UN7FGO/MK61S_MINI/doc/MK61s-mini-Terminal.pdf

Проект
«Эмулятор микрокалькулятора «Электроника МК-61s mini» https://github.com/UN7FGO/MK61S_MINI

Руководство по работе с терминалом

Подключение к терминалу производится через последовательный порт ПК при помощи любой программы терминала, например Putty, TeraTerm или терминала ArduinoIDE. Характеристики соединения:

- 115200 Bod
- 8 bit + 1 bit четности

Предпочтительный размер окна терминала, 40 строк по 80 символов в строке. Для корректного отображения символов кириллицы, установите кодовую страницу Win1251.

Небольшое лирическое отступление, о терминале и том, что мы в нем наделали

Ввиду того, что само устройство, как и оригинал, не обладают большим дисплеем и не в состоянии отображать много информации одновременно, было решено создать инструмент, который позволит получить доступ к “внутреннему миру” устройства в более комфортном виде. Для этих целей и был выбран терминал, как наиболее простой и интуитивный способ общения с устройством.
Терминал дает возможность доступа к внутренней информации устройства, которая в оригинале была скрыта от пользователя или представлена в совсем уж минималистичном виде.
При работе с устройством, необходимо помнить, что его внутренняя организация, отличается от привычной нам. Программируемые калькуляторы 80-х годов прошлого века, создавались по Гарвардской архитектуре. Это означает, что память программы и память данных, это два разных устройства. В нашем случае, эта память не только разная, но она и организована по разному. Так, если память программы имеет байтовую организацию, то память данных имеет структуру вещественного числа и содержит мантиссу и порядок числа.
Для удобства работы с программным кодом, мы ввели в терминал, возможность работы с программным кодом, на языке ассемблера. Однако и тут у нас не обошлось без нюансов, связанных со структурой команд самого программируемого калькулятора. Особенность заключается в том, что в коде
калькулятора | переход | на | указанный | адрес | происходит | в | случае
НЕВЫПОЛНЕНИЯ условия. В связи с чем команды языка ассемблера выглядят “зеркальными” к обозначениям на нажимаемых кнопках устройства.

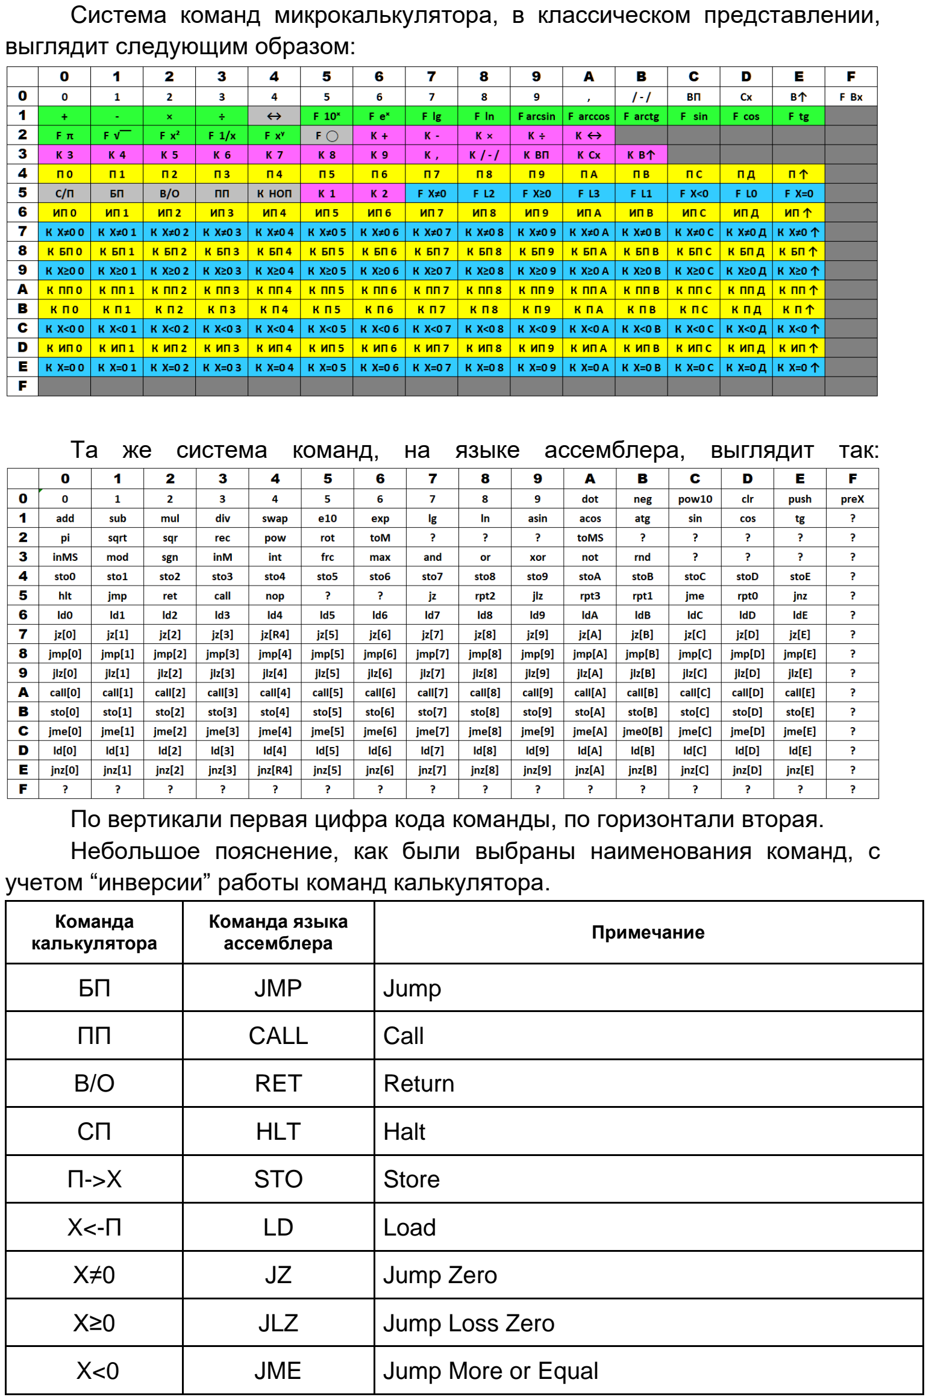
[picture p12: page 2]

Система команд микрокалькулятора, в классическом представлении, выглядит следующим образом:

Та же система команд, на языке ассемблера, выглядит так:

По вертикали первая цифра кода команды, по горизонтали вторая. Небольшое пояснение, как были выбраны наименования команд, с учетом “инверсии” работы команд калькулятора.

Команда калькулятора | Команда языка ассемблера | Примечание
БП | JMP | Jump
ПП | CALL | Call
В/О | RET | Return
СП | HLT | Halt
П->X | STO | Store
X<-П | LD | Load
X≠0 | JZ | Jump Zero
X≥0 | JLZ | Jump Loss Zero
X<0 | JME | Jump More or Equal

X=0 | JNZ | Jump No Zero

Описание команд терминала МК-61s-mini

ver - версия ПО калькулятора

list | - | выводит | содержимое | программной | памяти | МК-61s-mini | в
шестнадцатеричном виде, с указанием адреса ячейки памяти.

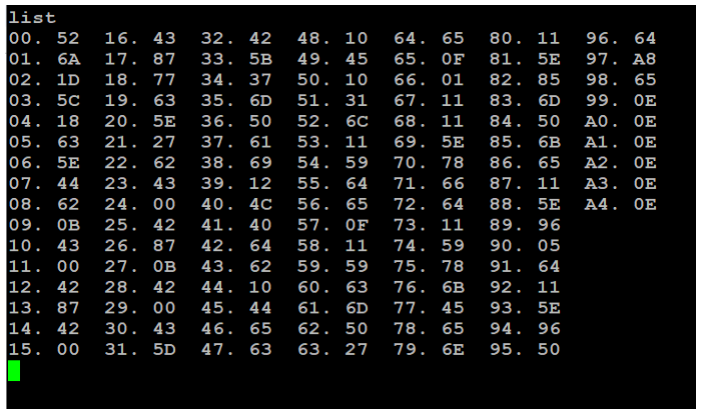
[picture p13: figure]

reg - выводит значение всех регистров памяти МК-61s-mini, в формате оригинального МК-61.

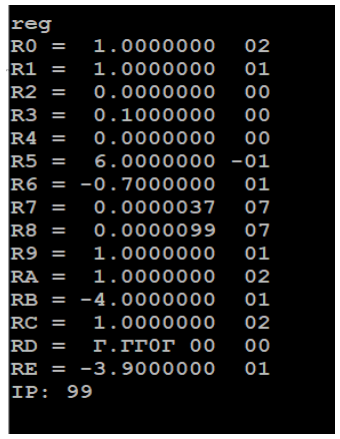
[picture p14: figure]

stk - (Stack) выводит текущее состояние стека МК-61-s-mini. Состояние регистров стека, отображается так, как оно выглядит в микрокалькуляторе.

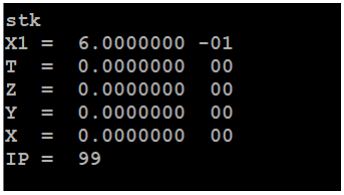
[picture p15: figure]

1302 - вывод содержимого регистра R К145ИК1302

asm - ассемблирование строки текста и ввод программы из этой строки (терминала) в программную память МК-61s-mini. Обязательно за словом asm размещать один пробел! В конце строки так же ставится завершающий пробел. Применяемые мнемоники могут быть просмотрены по запросу, командой ISA.
Опционально в команде asm может присутствовать адрес трансляции (ТА) в виде 4 разрядного числа.

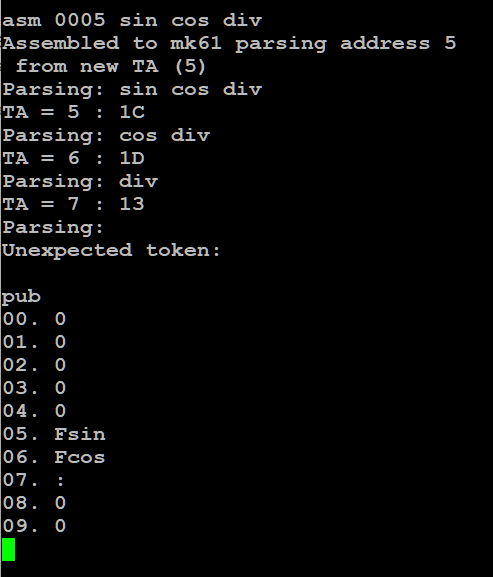
[picture p16: figure]

При отсутствии адреса в строке ассемблирования (по умолчанию) трансляция ведется с текущего значения ТА.

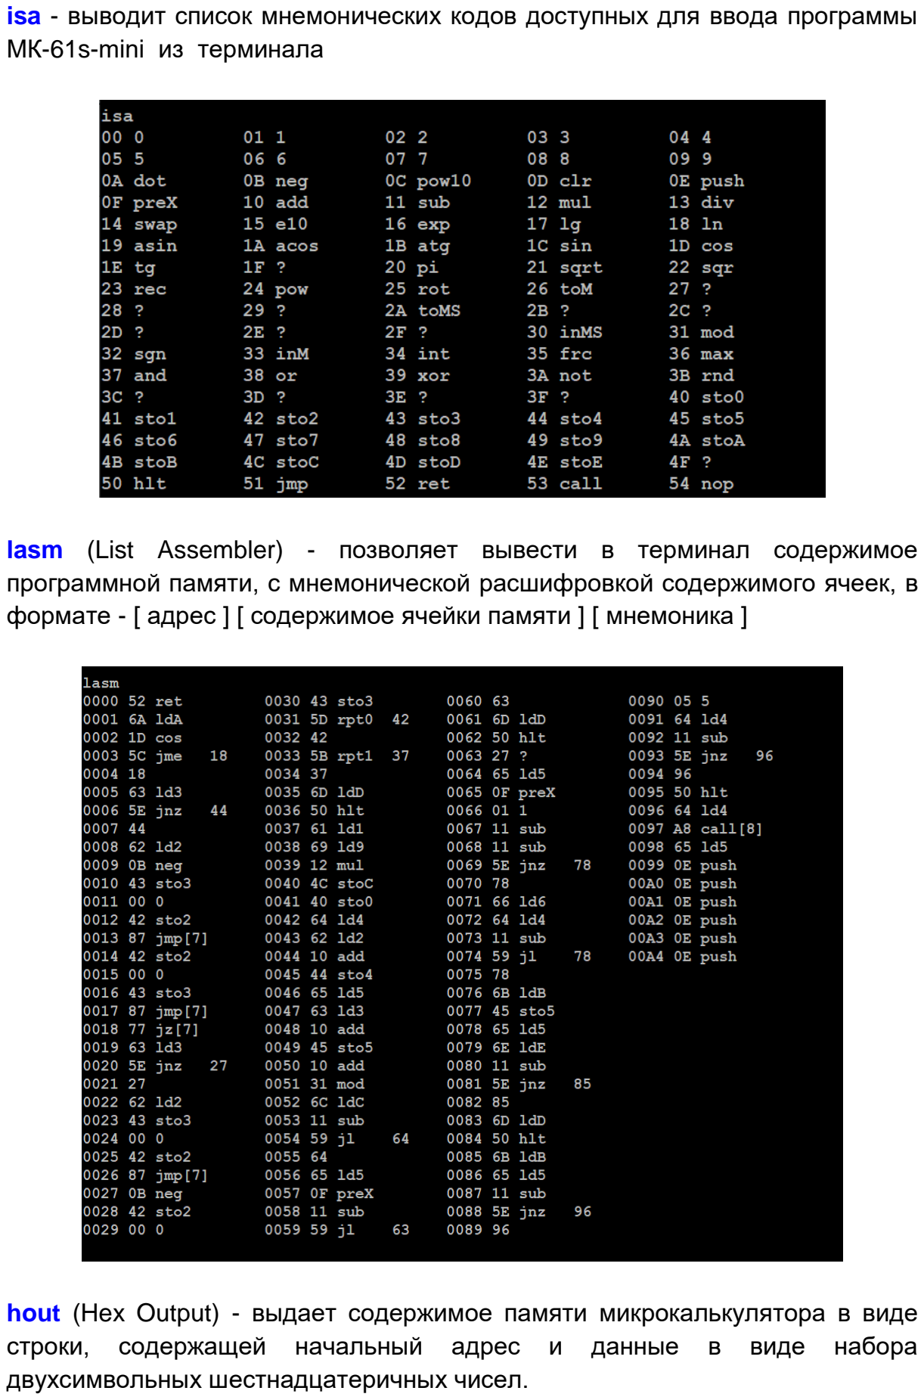
[picture p17: page 5]

isa - выводит список мнемонических кодов доступных для ввода программы МК-61s-mini из терминала

lasm (List Assembler) - позволяет вывести в терминал содержимое программной памяти, с мнемонической расшифровкой содержимого ячеек, в формате - [ адрес ] [ содержимое ячейки памяти ] [ мнемоника ]

hout (Hex Output) - выдает содержимое памяти микрокалькулятора в виде
строки, | содержащей | начальный | адрес | и | данные | в | виде | набора
двухсимвольных шестнадцатеричных чисел.

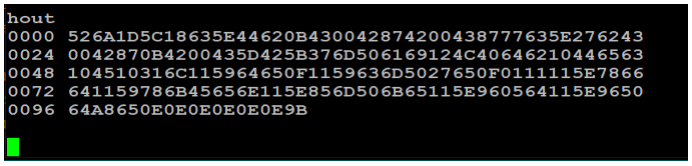
[picture p18: figure]

hin [адрес] [значение] (Hex Input) - помещает указанное значение по указанному адресу. Адрес указывается в четырехзначном формате. Значение указывается в двузначном-шестнадцатеричном виде.

Данные для команды hin, могут быть получены командой hout, что позволит вам поделиться своей программой с другим человеком.

ins (Insert) – вставляет в программу, по указанному адресу операцию с указанным кодом, при этом сдвигая все последующие команды и корректирует условные и безусловные переходы.
Ins [адрес] [код команды]
Адрес указывается в десятично-шестнадцатеричном виде, код команды в шестнадцатеричном.

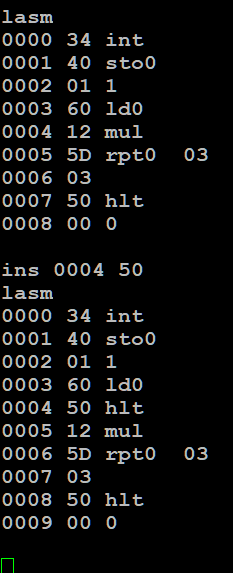
[picture p19: figure]
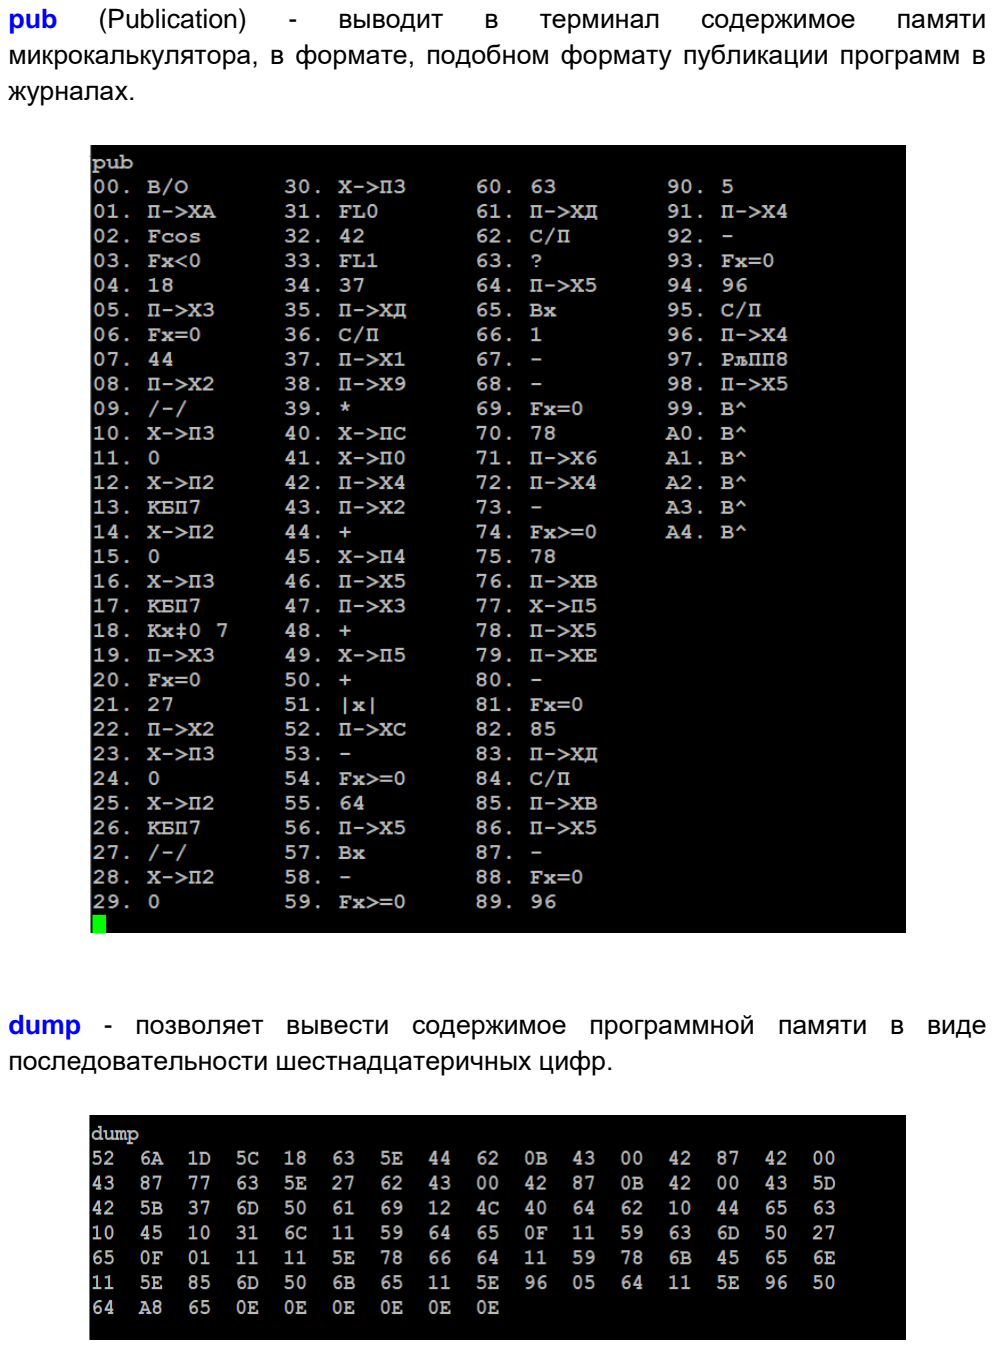
[picture p20: page 7]

pub | (Publication) | - | выводит | в | терминал | содержимое | памяти
микрокалькулятора, в формате, подобном формату публикации программ в журналах.

dump - позволяет вывести содержимое программной памяти в виде последовательности шестнадцатеричных цифр.

poke [имя регистра стека] [значение] - помещает указанное значение в указанный регистр стека. Имя регистра, указывается в виде одной буквы (X, Y, Z, T). Значение указывается в нормализованном формате, с указанием порядка числе, через латинскую букву “e”.

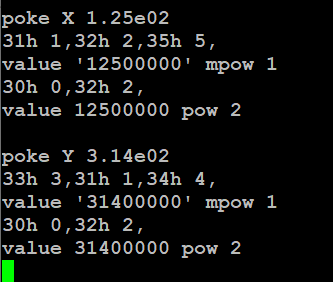
[picture p21: figure]

kbd [код команды] - эмулирует нажатие на клавиатуры комбинации клавиш с указанным скан-кодом. [код команды] указывается в шестнадцатеричном формате и не может превышать 27h. Скан-коды клавиш можно увидеть на приложенной картинке.

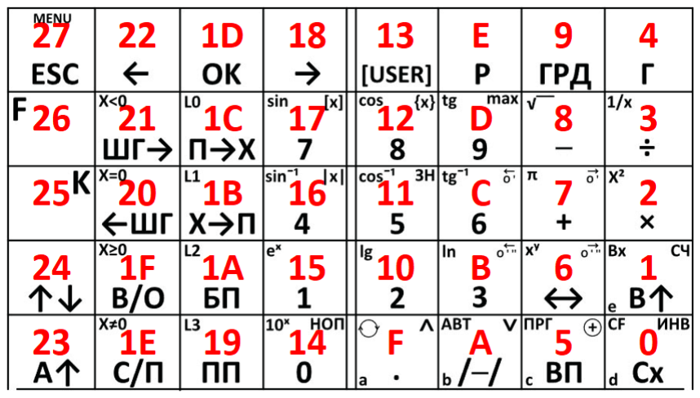
[picture p22: figure]

Однако нужно иметь ввиду, что при попытке вызова меню, командой терминала (kbd 27), терминал становится на паузу и пока вы не выйдете из сервисного меню на устройстве, продолжить работу с терминалом не получится.

Пример комбинации действий терминала. poke X 1.25e02
poke Y 3.14e02
kbd 2
stk

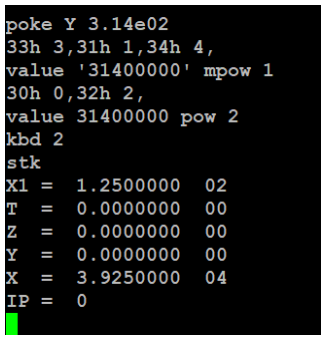
[picture p23: figure]

Вводим в регистр стека X значение 125. Вводим в регистр стека Y значение 314. Имитируем нажатие клавиши [ умножить ]. Просматриваем результат в регистре стека X. Результат этих действий также отображается на дисплее устройства в виде цифры 39250.

smap (Slot Map) - для быстрой оценки занятости SPI FLASH памяти и поиска свободных слотов, отображает матрицу слотов в формате 10х10, с указанием занятых.

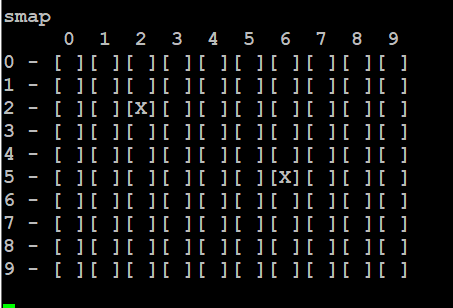
[picture p24: figure]

snm [номер слота] [имя слота] - присваивает слоту, в SPI FLASH памяти, с указанным номером, указанное имя. Номер слота - двузначное десятичное число. Имя слота - строка состоящая из латинских букв, цифр или символов, длиной не более 14 символов.
Пример:
sname 01 BE-HAPPY
sname 22 FISHING sdir (Slot Directory) - отображает список занятых слотов SPI FLASH памяти, с его имени.

save [номер слота] - сохранение программы, из памяти МК-61s-mini в указанный слот, внешней SPI FLASH памяти. Номер слота - двузначное десятичное число. Если слот уже занят другой программой, то спрашивает подтверждение действия - Y / N.

load [номер слота] - чтение программы в память МК-61s-mini из указанного слота, внешней SPI FLASH памяти. Номер слота - двузначное десятичное число. Если указанный слот пустой, то сообщает об этом звуковым сигналом.

sera (Slots Erase) - Удаляет содержимое всех слотов, в SPI FLASH памяти, помечает их как свободные и стирает их имена . Перед удалением, спрашивает подтверждение действия - Y / N.

sdel [номер слота] (Slot Delete) - помечает указанный слот, в SPI FLASH памяти, незанятым и удаляет имя слота. Номер слота - двузначное десятичное число. Перед удалением, спрашивает подтверждение действия -Y / N. Если указанный слот пустой, то сообщает об этом.

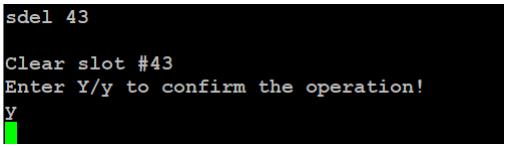
[picture p25: figure]

run | - | запуск | выполнения | программы | на | устройстве. | Аналогично
последовательности нажатия клавиш F АВТ, В/О, С/П. По окончании выполнения программы, в терминал выдается соответствующее сообщение.

exec - шаг по программе МК-61s-mini в режиме отладки - эквивалентно нажатию клавиши ПП

clr - очищает программную память. Действие требует подтверждения со стороны пользователя, отправкой символа “Y”. Отменить данную операцию не представляется возможным.

rst - перезагрузка микроконтроллера

dfu - переход в режим загрузки микроконтроллера по DFU (Device Firmware Uploader или Device Firmware Upgrade).

disa - включение/выключение режима дизассемблера, во всех режимах работы калькулятора, а не только в режиме ввода программы ПРГ
