UN7FGO/MK61S_MINI/code/library_pmk.cpp

#include  "library_pmk.hpp"
#include  "rust_types.h"
#include  "mk61emu_core.h"
#include  "lcd_gui.hpp"
#include  "keyboard.h"
#include  "cross_hal.h"
#include "debug.h"

static  i8          selProgram, selGame;

static const u32 Factorial_size       = 1 + 8 + 1;
static const u32 Fox_hunting_size     = 1 + 105 + 1;
static const u32 Naval_battle_size    = 1 + 105 + 7*2 + 1;
static const u32 Bumblebee_fly_size   = 1 + 105 + 3*7 + 2*4 + 6 + 2*4 + 7 + 4 + 1;
static const u32 Double_interpol_size = 1 + 105 + 10*4 + 1;
static const u32 Infinity_story_size  = 1 + 105 + 11*4 + 6 + 1;
static const u32 Simple_num_size      = 1 +  27 + 1;
static const u32 e_num_size           = 1 + (6 + 6 * 16) + 1;
static const u32 lunolet1_size        = 1 + (2 + 6 * 16) + (4 + 8*4) + 1;
static const u32 dec2nat              = 1 + (3 * 16 + 2) + 4 + 1;
static const u32 powerUR              = 1 + (2 * 16 + 14) + 1;

static  TPunct programs[COUNT_PROGRAMS] = {
//          0123456789ABCDEF
  {.text = "Factorial      ", .offset = 0},
  {.text = "Double interpol", .offset = Factorial_size},
  {.text = "Simple number  ", .offset = Factorial_size + Double_interpol_size},
  {.text = "Compute e-num  ", .offset = Factorial_size + Double_interpol_size + Simple_num_size},
  {.text = "dec  => natural", .offset = Factorial_size + Double_interpol_size + Simple_num_size + e_num_size},
  {.text = "Power for U & R", .offset = Factorial_size + Double_interpol_size + Simple_num_size + e_num_size + dec2nat}
};

static  TPunct games[COUNT_GAMES] = {
//          0123456789ABCDEF
  {.text = "Fox hunting    ", .offset = 0},
  {.text = "Naval battle   ", .offset = Fox_hunting_size},
  {.text = "Bumblebee fly  ", .offset = Fox_hunting_size + Naval_battle_size},
  {.text = "Infinity store ", .offset = Fox_hunting_size + Naval_battle_size + Bumblebee_fly_size},
  {.text = "Lunolet-1      ", .offset = Fox_hunting_size + Naval_battle_size + Bumblebee_fly_size + Infinity_story_size}
};

static  u8          mk61_games[] = {
// Fox hunting  
  9 + 6 * 16,
//  0     1     2     3     4     5     6     7     8     9     A     B     C     D     E     F
  0x40, 0x09, 0x42, 0x43, 0x00, 0x45, 0x46, 0xD5, 0x65, 0x41, 0x02, 0x15, 0x20, 0x60, 0x07, 0x12, 
  0x10, 0x35, 0x40, 0x12, 0x34, 0x22, 0x14, 0x13, 0x22, 0x05, 0x44, 0xD4, 0x11, 0x57, 0x08, 0x3E, 
  0x5B, 0x27, 0xB4, 0x58, 0x07, 0x11, 0x44, 0x63, 0x0B, 0xB4, 0x61, 0x14, 0x50, 0x62, 0x15, 0x45, 
  0x12, 0x34, 0x65, 0x13, 0x41, 0x59, 0x93, 0x65, 0x11, 0x5C, 0x93, 0xD6, 0x63, 0x42, 0x06, 0x44, 
  0x00, 0x45, 0x64, 0x61, 0xD4, 0x59, 0x66, 0x21, 0x21, 0x11, 0x57, 0x99, 0x0F, 0x35, 0x61, 0x35, 
  0x11, 0x57, 0x93, 0x10, 0x57, 0x93, 0x0F, 0x13, 0x31, 0x17, 0x17, 0x5E, 0x94, 0xD5, 0x58, 0x66, 
  0x65, 0x51, 0x42, 0x5A, 0x37, 0x66, 0x03, 0x23, 0x50,
  0xFF,
// Naval battle
  9 + 6 * 16,
//  0     1     2     3     4     5     6     7     8     9     A     B     C     D     E     F
  0x51, 0x50, 0x5C, 0x89, 0x5D, 0x68, 0x6A, 0x52, 0x04, 0x53, 0x76, 0x6D, 0x10, 0x4E, 0x14, 0x07, 
  0x53, 0x76, 0x15, 0x14, 0x08, 0x13, 0x0B, 0x0C, 0x23, 0x34, 0x11, 0xDE, 0x37, 0x35, 0x52, 0x6C, 
  0x07, 0x12, 0x20, 0x10, 0x35, 0x4C, 0x53, 0x71, 0xAB, 0xEA, 0x25, 0xDE, 0x39, 0xBE, 0x10, 0x32, 
  0x4D, 0x52, 0x34, 0x40, 0x17, 0x09, 0x4D, 0xBD, 0x01, 0x11, 0x5E, 0x54, 0x60, 0x41, 0x15, 0xAA, 
  0x5B, 0x63, 0x60, 0x41, 0x05, 0x4D, 0xAA, 0x6C, 0x0C, 0x02, 0x34, 0x52, 0x3E, 0x0F, 0x14, 0x0F, 
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
  0x45, 0x67, 0x46, 0x64, 0x67, 0x13, 0x60, 0x11, 0x31, 0x69, 0x11, 0x5C, 0x09, 0x67, 0x64, 0x50, 
  0x51, 0x00,
//
  0x09, 0x41, 0x93, 0x10,       // R9 = 1E-7
  0xFF,
// Подсчет мощности на резисторе U,R
  2*16 + 14,
  0x08, 0x0A, 0x05, 0x04, 0x04, 0x06, 0x06, 0x06, 0x03, 0x4E, 0x0D, 0x50, 0x22, 0x08, 0x0A, 0x02, 
  0x04, 0x04, 0x07, 0x09, 0x07, 0x07, 0x0C, 0x06, 0x03, 0x4E, 0x0D, 0x50, 0x14, 0x25, 0x13, 0x08, 
  0x0A, 0x07, 0x04, 0x04, 0x06, 0x06, 0x08, 0x04, 0x0C, 0x06, 0x01, 0x4E, 0x14, 0x50,
  0xFF
};

// registers = 0.0 {sign_num(8-bit)|sign_pow(7-bit)|len(bytes for mantisa), abs(pow), mantissa... }
const u8 pack_clear_register[3] = {0x01, 0x00, 0x00};  // 0.0

void  init_library(void) {
  selProgram = 0;
  selGame = 0;
}

int   select_from(usize COUNT, TPunct* list, i8& selector) {
  do {
    const int delta = (selector + 1) - 2;
    const int up = (delta <= 0)? 0 : delta;

    for(int i=0; i < 2; i++) {
      lcd.setCursor(0,i); 
      const int real_index = i + up;
      if(selector == real_index) { 
        lcd.print('>');
      } else {
        lcd.print(' ');
      }
      lcd.print(list[real_index].text);
    }

    const i32 last_key_code = kbd::get_key_wait();
    switch(last_key_code) {
      case KEY_RIGHT_PRESS:
          if((isize) selector < (isize) (COUNT-1)) selector++;
        break;
      case KEY_LEFT_PRESS:
          if(selector > 0) selector--;
        break;
      case KEY_ESC_PRESS:
        return -1; // отмена
      case KEY_OK_PRESS:
        #ifdef SERIAL_OUTPUT
          Serial.print("load code '");
          Serial.print(list[selector].text);
          Serial.print("' offset: ");
          Serial.println(list[selector].offset);
        #endif 
        lcd.clear();
        lcd.setCursor(0, 0); lcd.print(list[selector].text);
        //                              456789AbCDEF
        lcd.setCursor(0, 2); lcd.print("is loaded.");
        delay(1500);
        return selector;
    }

  } while(true);
}

void  load_from(usize offs, /*TPunct* list,*/ u8* data_stream) {
  for(u8 nReg=0; nReg < 0x0F; nReg++) MK61Emu_UnpackRegster(nReg, (u8*) &pack_clear_register);  // clear registers

  const u32 code_len = data_stream[offs++];
  for(u32 addr=0; addr < 105; addr++) {
      const u8 store_data = (addr < code_len)? data_stream[offs++] : 0;
      MK61Emu_SetCode(core_61::get_ring_address(addr), store_data);
  }

  u8* pPack_number = &data_stream[offs];
  while(*pPack_number != 0xFF) {
    const u8 RegisterN = *pPack_number++;
    dbghexln(LIB61, "unpack reg: ", RegisterN);
    pPack_number = MK61Emu_UnpackRegster(RegisterN, pPack_number);
  }
}

int   select_program(void) {
  return select_from(COUNT_PROGRAMS, programs, selProgram);
}

int   select_game(void) {
  return select_from(COUNT_GAMES, games, selGame);
}

void  load_program(usize nProg_for_load) {
  load_from(/*nProg_for_load,*/ programs[nProg_for_load].offset, mk61_lib);
}

void  load_game(usize nGame_for_load) {
  load_from(/*nGame_for_load,*/ games[nGame_for_load].offset, mk61_games);
}
