UN7FGO/MK61S_MINI/code/rust_types.h

#ifndef RUST_TYPES_DESCRIPTION
#define RUST_TYPES_DESCRIPTION
#include <stdint.h>

typedef   uint8_t         u8;
typedef   int8_t          i8;
typedef   short unsigned  u16;
typedef   int16_t         i16;
typedef   uint32_t        u32;
typedef   int32_t         i32;
typedef   uint64_t        u64;
typedef   int64_t         i64;
typedef   unsigned int    usize;
typedef   int             isize;
typedef   u32             t_time_ms;
#endif
