UN7FGO/MK61S_MINI/code/tools.hpp

#ifndef TOOLS
#define TOOLS

#include "rust_types.h"
#include "EEPROM.h"
#include "mk61emu_core.h"

#include "debug.h"

static constexpr usize FLASH_SECTOR_SIZE    = 4096;
static constexpr u8    SLOT_OCCUPIED        = 0x55;
static constexpr usize OFFSET_FLAG_OCCUPIED = 0;
static constexpr usize OFFSET_MK61_PROGRAMM = 1;
static constexpr usize OFFSET_SLOT_NAME     = 384;
static constexpr usize SIZEOF_SLOT_NAME     = 16;
static constexpr isize MAX_SLOT_FOR_PROGRAM = 99;
static constexpr isize BLOCK_SIZE           = 106 / 13;

static const int switch_R_GRD_G = 106;
static const int count_switch_R_GRD_G = 107;

extern  void  DFU_enable(void);
extern  void  sound(usize pin, isize freq_Hz, usize duration_ms);

extern  void  message_and_waitkey(const char* lcd_message);
extern  bool  Confirmation(void);

extern  bool  flash_is_ok;
extern  isize calc_address(usize nSlot);
extern  char* ReadSlotName(usize nSlot, char* slot_name);
extern  bool  Rename(usize nSlot, char* slot_name);
extern  bool  Store(void);
extern  bool  Store(usize nSlot);
extern  bool  Load(void);
extern  bool  Load(usize nSlot);
extern  u8    load_word(isize segment_address, isize offset);
extern  bool  EraseFlash(void);
extern  bool  clear_storage(void);
extern  bool  erase_slot(usize nSlot);
extern  void  init_external_flash(void);

extern usize  seek_program_END(u8* code_page);
extern  void  insert_cmd_in_program(usize into_step, usize opcode);

inline bool IsOccupied(usize nSlot) {
   return (load_word(nSlot * FLASH_SECTOR_SIZE, OFFSET_FLAG_OCCUPIED) == SLOT_OCCUPIED);
}

inline void ErrorReaction(void) {
  sound(PIN_BUZZER, 4000, 750);
}

inline bool IsDecimalDigit(char symbol) {
  return ((symbol >= '0') && (symbol <= '9'));
}

inline isize DecimalDigit(char Symbol) {
  Symbol -= '0';
  return (Symbol <= 9)? Symbol : -1;
}

inline isize HexdecimalDigit(char Symbol) {
  if(Symbol >= '0' && Symbol <= '9')
    return Symbol - '0';
  else if (Symbol >= 'A' && Symbol <= 'F')
    return Symbol - 'A' + 10;
  else if (Symbol >= 'a' && Symbol <= 'f')
    return Symbol - 'a' + 10;
  else 
    return -1;
}

#ifdef SERIAL_OUTPUT
inline void Serial_write_hex(u8 code) {
    if(code < 0x10) Serial.write('0');
    Serial.print(code, HEX);
}

inline void Serial_writeln_hex(u8 code) {
    if(code < 0x10) Serial.write('0');
    Serial.println(code, HEX);
}
#endif

inline u64 pad_left_8_char(char* string_8_char) {
  u64 result = *(uint64_t*) string_8_char;
  while((result & 0x0000FF0000000000) == 0) {
    result = (result << 8) | 0x0000000000000020;
  }
  return result;
}

inline AngleUnit read_grade_switch(void) {
  return (AngleUnit) EEPROM.read(switch_R_GRD_G);
}

inline u8 read_counter_switch(void) {
  return EEPROM.read(count_switch_R_GRD_G);
}

inline AngleUnit load_grade_switch(void) {
  static const AngleUnit rom_angle = (AngleUnit) EEPROM.read(switch_R_GRD_G);
  if(rom_angle == RADIAN || rom_angle == GRADE || rom_angle == DEGREE) { // состояние переключателя считано из флеш как определнное (радианы или грады)
    MK61Emu_SetAngleUnit(rom_angle);
    dbgln(SPIROM, "get grade_switch ", rom_angle);
    return rom_angle;
  } else { // из флеш считано либо "чистое" значение (FF - градусы), либо неопределенное в следствии сбоя очистки и записи в флеш
    MK61Emu_SetAngleUnit(DEGREE);
    dbgln(SPIROM, "get grade_switch as CLEAR (FF) set to ", DEGREE);
    return DEGREE;
  }
}

inline void store_grade_switch(AngleUnit angle_unit) {
  EEPROM.update(switch_R_GRD_G, (u8) angle_unit);
  EEPROM.update(count_switch_R_GRD_G, read_counter_switch() + 1);
}

#endif
