UN7FGO/MK61S_MINI/(commit log)

2024-11-22 Обновление документации проекта
    Актуализированы фотографии и добавлена инструкция по Терминалу
2024-11-22 Обновление файлов прошивок
2024-11-29 optimization, ~1k footprint trim
2024-12-11 Add files via upload
    1. Исправлена трасса ядра (была ошибка тайпкаста)
    2. Исправления терминала команда hout захватала лишних два байта с конца.
    3. Исправление модуля debug введена новая функция отладки - слежение за значением.
    [config.h, debug.cpp, debug.h, mk61emu_core.cpp, mk61s-M.ino, terminal.hpp, tools.cpp]
