UN7FGO/MK61S_MINI/(notices)

Notices in the files:
code/mk61emu_core.cpp:
This program is free software: you can redistribute it and/or modify
it under the terms of the GNU General Public License as published by
the Free Software Foundation, version 3.
